IsaacDisnaut/RobotHead/robotface.png

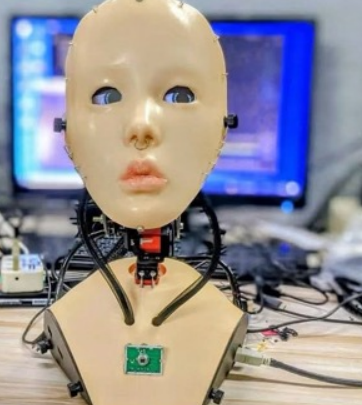
robotface.png
