IsaacDisnaut/RobotHead/README.md

# RobotHead — หุ่นยนต์หัว "น้องมะลิ"

หุ่นยนต์หัวพนักงานต้อนรับร้านเบเกอรี่ คุยภาษาไทยด้วยเสียงได้ หันหน้าตามคนที่อยู่ตรงหน้าหรือคนที่กำลังพูด กลอกตาบนจอกลมสองจอ และขยับปากตามเสียงพูด

- **ตา**: จอกลม GC9A01 1.28" × 2 แสดงลูกตาที่กะพริบ กลอกตา และม่านตาขยาย-หดได้
- **คอ**: เซอร์โว 2 ตัว (หันซ้าย-ขวา / ก้ม-เงย) ควบคุมด้วย ESP32-S3
- **ปาก**: เซอร์โว MG90S ควบคุมด้วย Arduino Nano ขยับตามเสียงพูด
- **สมอง**: โปรแกรม Python บนคอม ใช้กล้องหาใบหน้า ไมค์ฟังเสียง AI คิดคำตอบ แล้วพูดออกลำโพง
- **ความรู้**: ไฟล์ข้อความในโฟลเดอร์ [`information/`](information/) เช่น เมนูและราคา ข้อมูลร้าน

มีโปรแกรมให้เลือกใช้ 2 แบบ

| | โปรแกรมจำลอง (`simulator/`) — **แนะนำ** | `robot_brain.py` (รุ่นเดิม) |
|---|---|---|
| หน้าตา | เว็บในเบราว์เซอร์ มีโมเดลหุ่น 3D | หน้าต่างกล้อง OpenCV |
| AI | Groq (`api.txt`) | Gemini (`gemini_key.txt`) |
| อ่านโฟลเดอร์ `information/` | ✅ | ❌ |
| หันหาคนที่กำลังพูด | ✅ | ❌ (หันหาคนที่ใกล้สุดเท่านั้น) |
| เลือกลำโพงได้ | ✅ | ❌ (ใช้ลำโพงหลักของ Windows) |
| ใช้ได้โดยไม่ต่อหุ่นจริง | ✅ | ❌ |

---

## โครงสร้างโฟลเดอร์

```
├── simulator/                 โปรแกรมจำลอง + ตัวควบคุมหุ่นจริงผ่านเว็บ
│   ├── robot_sim_server.py    เซิร์ฟเวอร์ (AI, แปลงเสียง, กล้อง, Serial)
│   ├── เปิดโปรแกรมจำลองหุ่น.bat  ดับเบิลคลิกเพื่อเปิด
│   ├── web/                   หน้าเว็บ (Three.js)
│   └── models/                โมเดลตรวจจับใบหน้า YuNet (ใช้เมื่อ OpenCV ไม่มี Haar cascade)
├── firmware/
│   ├── robot_head/            เฟิร์มแวร์ ESP32-S3 (ตา + คอ)
│   └── jawduino/              เฟิร์มแวร์ Arduino Nano (ปาก)
├── information/               ข้อมูลที่หุ่นใช้ตอบคำถาม (.txt .md .csv .json .docx .pdf)
├── 3D_Print/                  ไฟล์ STL + G-code ลำตัวและโครงหัว (PETG)
├── robot_brain.py             สมองหุ่นรุ่นเดิม (ไม่ใช้เว็บ)
├── test_move.py               ทดสอบขยับหัวผ่าน Serial
├── haarcascade_frontalface_default.xml   โมเดลตรวจจับใบหน้า
├── โค้ดทั้ง2ฝั่ง/                โค้ดและผังวงจรรุ่นแรก (เก็บไว้อ้างอิง)
└── *.jpg                      ผังการต่อสาย ESP32-S3 / จอ GC9A01
```

---

## 1. ฮาร์ดแวร์และการต่อสาย

### อุปกรณ์

| อุปกรณ์ | จำนวน | หน้าที่ |
|---|---|---|
| ESP32-S3 (Flash 16MB, PSRAM OPI) | 1 | คุมจอตาและเซอร์โวคอ |
| จอกลม GC9A01 1.28" | 2 | ดวงตา |
| เซอร์โว (คอ) | 2 | Pan หันซ้าย-ขวา / Tilt ก้ม-เงย |
| Arduino Nano | 1 | คุมปาก |
| เซอร์โว MG90S | 1 | ขากรรไกร |
| แหล่งจ่ายไฟ 5V 2–3A | 1 | เลี้ยงเซอร์โวทุกตัว |
| เว็บแคม + ไมโครโฟน | 1 | ตาและหูของสมองบนคอม |
| ลำโพง (USB หรือสาย jack 3.5 มม.) | 1 | เสียงพูด ต่อกับคอม |
| โมดูล KA2284 | 1 | *ไม่บังคับ* — ตัวสำรองให้ปากขยับตามเสียงโดยไม่ต้องใช้คอม |

### ESP32-S3

| ต่อจาก | ไปที่ ESP32-S3 |
|---|---|
| จอ GC9A01 ทั้ง 2 จอ — DIN / SDA | GPIO 11 |
| จอ GC9A01 ทั้ง 2 จอ — SCL / SCLK | GPIO 12 |
| จอ GC9A01 ทั้ง 2 จอ — DC | GPIO 8 |
| จอซ้าย — CS | GPIO 10 |
| จอขวา — CS | GPIO 14 |
| เซอร์โว Pan — สายสัญญาณ (ส้ม/เหลือง) | GPIO 17 |
| เซอร์โว Tilt — สายสัญญาณ (ส้ม/เหลือง) | GPIO 18 |

> ⚠️ **ห้ามเลี้ยงเซอร์โวจากขา 5V ของบอร์ด** เซอร์โวดึงกระแสสูง ทำให้บอร์ดรีเซ็ตเอง ให้ใช้แหล่งจ่าย 5V ภายนอก แล้วต่อ GND ของแหล่งจ่ายเข้ากับ GND ของบอร์ด (Common Ground)

ดูรูปผังเพิ่มได้ที่ไฟล์ `การต่อ esp32 s3.jpg`, `การต่อ server esp32 s3.jpg` และ `การต่อจอแสดงผล GC9A01 (...).jpg`

### Arduino Nano (ปาก)

| ต่อจาก | ไปที่ |
|---|---|
| เซอร์โว MG90S — สายสัญญาณ (ส้ม) | Nano D9 |
| เซอร์โว MG90S — ไฟ (แดง) / กราวด์ (น้ำตาล) | แหล่งจ่าย 5V ภายนอก (GND ต่อร่วมกับ GND ของ Nano) |
| Nano USB | คอม (เส้นแยกจาก ESP32) |
| *(ไม่บังคับ)* KA2284 ขาลบ LED D2 / D3 / D4 | Nano A0 / A1 / A2 |

ถ้าไม่ได้ต่อ KA2284 ก็ไม่เป็นไร เฟิร์มแวร์ดึงขาไว้ด้วย `INPUT_PULLUP` อยู่แล้ว

---

## 2. ติดตั้งโปรแกรมบนคอม (Windows)

1. ติดตั้ง **Python 3.10** จาก [python.org](https://www.python.org/downloads/) ตอนติดตั้งให้ติ๊ก **Add Python to PATH**
2. เปิด Command Prompt ในโฟลเดอร์โปรเจกต์ แล้วติดตั้ง library

   ```bat
   pip install -r requirements.txt
   ```

   ถ้าติดตั้ง `PyAudio` ไม่ผ่าน ข้ามไปได้ถ้าใช้แค่โปรแกรมจำลอง (มันใช้แค่กับ `robot_brain.py`)

3. ใส่ API key (ไฟล์เหล่านี้อยู่ใน `.gitignore` จะไม่ขึ้น git)

   | ไฟล์ | ใช้กับ | ขอ key ที่ |
   |---|---|---|
   | `api.txt` | โปรแกรมจำลอง (Groq: คุย + แปลงเสียงเป็นข้อความ) | [console.groq.com/keys](https://console.groq.com/keys) |
   | `gemini_key.txt` | `robot_brain.py` (Gemini) | [aistudio.google.com/apikey](https://aistudio.google.com/apikey) |

   ใส่ key บรรทัดเดียวในไฟล์ เช่น `gsk_xxxxxxxx` หรือ `GROQ_API_KEY=gsk_xxxxxxxx` ก็ได้ ถ้าไม่มีไฟล์ จะอ่านจากตัวแปรสภาพแวดล้อม `GROQ_API_KEY` / `GEMINI_API_KEY` แทน

---

## 3. ลงเฟิร์มแวร์

ใช้ **Arduino IDE 2** (หรือ `arduino-cli`)

### ESP32-S3 — [`firmware/robot_head/robot_head.ino`](firmware/robot_head/robot_head.ino)

1. Boards Manager → ติดตั้ง **esp32 by Espressif Systems**
2. Library Manager → ติดตั้ง **GFX Library for Arduino** (moononournation) และ **ESP32Servo** (Kevin Harrington)
3. เลือกบอร์ด **ESP32S3 Dev Module** แล้วตั้งค่า
   - USB CDC On Boot: **Enabled**
   - Flash Size: **16MB**
   - PSRAM: **OPI PSRAM**
4. เปิด `robot_head.ino` (ไฟล์ภาพลูกตาอยู่ที่ `data/defaultEye.h` ต้องอยู่ข้างกัน) แล้วอัปโหลด

ด้วย arduino-cli: ค่าบอร์ดอยู่ใน [`sketch.yaml`](firmware/robot_head/sketch.yaml) แล้ว

```bat
cd firmware\robot_head
arduino-cli compile --upload -p COM12
```

### Arduino Nano — [`firmware/jawduino/jawduino.ino`](firmware/jawduino/jawduino.ino)

1. เลือกบอร์ด **Arduino Nano** (ถ้าอัปโหลดไม่ผ่าน ลอง Processor: **ATmega328P (Old Bootloader)**)
2. อัปโหลด
3. ปรับมุมปากให้เข้ากับกลไกได้ที่ `JAW_CLOSED` (หุบ) และ `JAW_OPEN` (อ้าสุด ไม่ควรเกิน 70)

---

## 4. ใช้งานโปรแกรมจำลอง (แนะนำ)

1. ดับเบิลคลิก `simulator/เปิดโปรแกรมจำลองหุ่น.bat`
   (หรือ `python simulator/robot_sim_server.py`)
2. เบราว์เซอร์จะเปิด <http://127.0.0.1:8765> เอง ให้ใช้ **Chrome หรือ Edge** → กด **คลิกเพื่อเริ่มจำลอง**
3. ปิดโปรแกรม: กด `Ctrl+C` ที่หน้าต่างดำ

### แท็บต่างๆ

| แท็บ | ทำอะไรได้ |
|---|---|
| 💬 คุยกับ AI | พิมพ์คุย, ปุ่มไมค์ (หยุดเองเมื่อเงียบ), โหมดฟังต่อเนื่อง |
| 🎮 ควบคุม | ปุ่มท่าทาง NOD/TILT/THINK/I, สไลเดอร์ Pan/Tilt/ตา, พิมพ์คำสั่ง Serial เอง, ทดสอบปาก |
| 📷 กล้อง | เปิดกล้องคอมเอง ตรวจหน้า และแสดงว่าหุ่นกำลังมองใคร (🎯 ใกล้สุด / 🗣️ กำลังพูด) |
| ⚙️ ตั้งค่า | กลับทิศเซอร์โว, ระยะที่เริ่มทักทาย, ความไวไมค์, ความเร็วเสียงพูด, **เลือกลำโพง**, ข้อมูลอ้างอิง, ต่อหุ่นจริง, สถานะ AI |

### ต่อหุ่นจริง

1. ปิด `robot_brain.py` และ Serial Monitor ของ Arduino IDE ก่อน (ใช้ COM พอร์ตเดียวกัน)
2. เสียบสาย USB ของ ESP32-S3 และ Nano — **เชื่อมต่อให้อัตโนมัติ** ไม่ต้องเลือก COM
   - เซิร์ฟเวอร์สแกนพอร์ต USB ทุก 3 วินาที ESP32-S3 ตอบ `STATUS ...` / Nano ตอบ `JAW OK`
   - ถอดสายแล้วเสียบใหม่ก็ต่อกลับเอง ป้ายด้านบนจะขึ้น "หุ่นจริง: COMx"
3. เลือกพอร์ตเองได้ที่แท็บ ⚙️ ตั้งค่า → **ต่อหุ่นจริง** ถ้ากด "ตัดการเชื่อมต่อ" ระบบจะหยุดค้นหาบอร์ดนั้นจนกว่าจะกดเชื่อมต่อใหม่
4. ไม่ต้องการให้ค้นหาเอง: `python simulator/robot_sim_server.py --no-serial`

### เลือกลำโพง

แท็บ ⚙️ ตั้งค่า → ช่องใต้ "ความเร็วเสียงพูด" → กด **ทดสอบ**
ถ้ายังไม่เคยเลือก ระบบจะเลือกลำโพงที่เสียบสาย jack (Realtek *Headphones*) ให้เอง
ชื่อลำโพงจะขึ้นหลังจากอนุญาตไมค์ครั้งแรก (กดไมค์หนึ่งครั้ง)

### หันหาคนที่กำลังพูด

ตอนไมค์ได้ยินเสียงพูด ระบบดูว่าใบหน้าไหนในกล้องขยับปากมากที่สุด แล้วหันไปหาคนนั้นแม้จะไม่ใช่คนที่ใกล้สุด พูดจบแล้วมองค้างไว้ 4 วินาที
ถ้าหันไม่ค่อยตรง ปรับ `SpeakerDetector.MIN_SCORE` ใน `robot_sim_server.py` (ดูตัวเลข 👄 บนจอกล้องประกอบ)

---

## 5. ใช้งาน `robot_brain.py` (รุ่นเดิม)

1. แก้ค่าด้านบนของไฟล์
   - `SERIAL_PORT` = COM ของ ESP32-S3
   - `JAW_SERIAL_PORT` = COM ของ Nano (หรือ `None` ถ้าไม่ต่อปาก)
2. รัน `py robot_brain.py`
3. ปิด: กดปุ่ม `q` ที่หน้าต่างกล้อง

---

## 6. ใส่ข้อมูลให้หุ่น (โฟลเดอร์ `information/`)

- ใส่ไฟล์ `.txt .md .csv .json .docx .pdf` ระบบโหลดใหม่เองเมื่อไฟล์เปลี่ยน
- ไฟล์ที่ชื่อขึ้นต้นด้วย `_` จะถูกข้าม (ใช้เก็บเทมเพลต/ร่าง)
- เขียนเป็นย่อหน้า เว้นบรรทัดว่างระหว่างหัวข้อ ขึ้นต้นด้วยหัวข้อที่ลูกค้าน่าจะถาม เช่น "เวลาเปิด-ปิด", "ราคาส่ง"
- หุ่นถูกสั่ง **ไม่ให้แต่งราคา/ตัวเลขที่ไม่มีในข้อมูล** ถ้าไม่มีจะบอกให้ถามพนักงาน
- เทมเพลตเมนู: [`information/_เมนูและราคา (เทมเพลต).txt`](information/_เมนูและราคา%20(เทมเพลต).txt)

> ราคาใน `เมนูและราคา.txt` ตอนนี้มาจากบทความรีวิวปี 2564 ควรอัปเดตเป็นราคาจริงของร้าน

---

## 7. คำสั่ง Serial (115200 baud)

### ESP32-S3

| คำสั่ง | ความหมาย |
|---|---|
| `T,pan,tilt,eyeX,eyeY` | หันหัว (pan 30–150, tilt 50–130, 90 = ตรง) และกลอกตา (0–1023, 512 = กลาง) ถ้าไม่ได้รับเกิน 2.5 วิ หุ่นกลับท่าพักเอง |
| `NOD` | ผงกหัว |
| `TILT` | เอียงคอฟัง |
| `THINK` | เหลือบตามองบน |
| `I` | กลับท่าพัก |
| `STATUS` | ตอบสถานะเซอร์โว/จอ |

### Arduino Nano (ปาก)

| คำสั่ง | ความหมาย |
|---|---|
| `J0` – `J100` | อ้าปาก 0 = หุบ, 100 = อ้าสุด (ไม่ได้รับเกิน 0.4 วิ จะกลับไปใช้ KA2284 / หุบปาก) |
| `DEBUG` | เปิด/ปิดการพิมพ์ค่าอนาล็อกจาก KA2284 |
| `PING` | ตอบ `JAW OK` |

ทดสอบหัวเร็วๆ: `py test_move.py COM12`

---

## 8. แก้ปัญหาที่พบบ่อย

| อาการ | วิธีแก้ |
|---|---|
| `AI ผิดพลาด: HTTP Error 429` | โควตา Groq ฟรีเต็ม ระบบจะสลับโมเดลสำรองให้เอง ถ้าเต็มทุกโมเดลให้รอสักพัก หรือลด `INFO_BUDGET` ใน `robot_sim_server.py` |
| เปิดกล้องไม่ได้ | ปิด `robot_brain.py` / โปรแกรมอื่นที่ใช้กล้อง แล้วกด **↻ เปิดกล้องใหม่** หรือเปลี่ยนหมายเลขกล้อง |
| เชื่อมต่อ COM ไม่ได้ | พอร์ตถูกใช้อยู่ (Arduino IDE Serial Monitor, `robot_brain.py`) ให้ปิดก่อน |
| เสียงไม่ออกลำโพงที่เลือก | ต้องใช้ Chrome/Edge และเสียงสำรองของเบราว์เซอร์ (ตอน gTTS ใช้ไม่ได้) จะออกลำโพงหลักของ Windows เสมอ |
| ปากจริงไม่ขยับ | เช็กว่าเชื่อมต่อพอร์ต Nano แล้ว พิมพ์ `PING` ใน Serial Monitor ต้องได้ `JAW OK` และเซอร์โวต้องมีไฟเลี้ยงภายนอก |
| บอร์ดรีเซ็ตเองตอนหัวขยับ | เซอร์โวกินไฟเกิน ใช้แหล่งจ่าย 5V 2–3A แยก และต่อ GND ร่วม |

---

## ชิ้นงานพิมพ์ 3 มิติ

ไฟล์อยู่ใน [`3D_Print/`](3D_Print/) — พิมพ์ด้วย PETG

| ชิ้น | STL | เวลาพิมพ์ |
|---|---|---|
| โครงหัว | `Head robot test01PLA.stl` | ~9 ชม. 14 นาที |
| ลำตัว | `body robot ok121069.stl` | ~10 ชม. 20 นาที |

ไฟล์ `.gcode` สไลซ์ไว้สำหรับเครื่องพิมพ์ที่ใช้ทำต้นแบบ ถ้าใช้เครื่องอื่นให้สไลซ์ใหม่จาก STL
