IsaacDisnaut/RobotHead/การต่อ esp32 s3.jpg

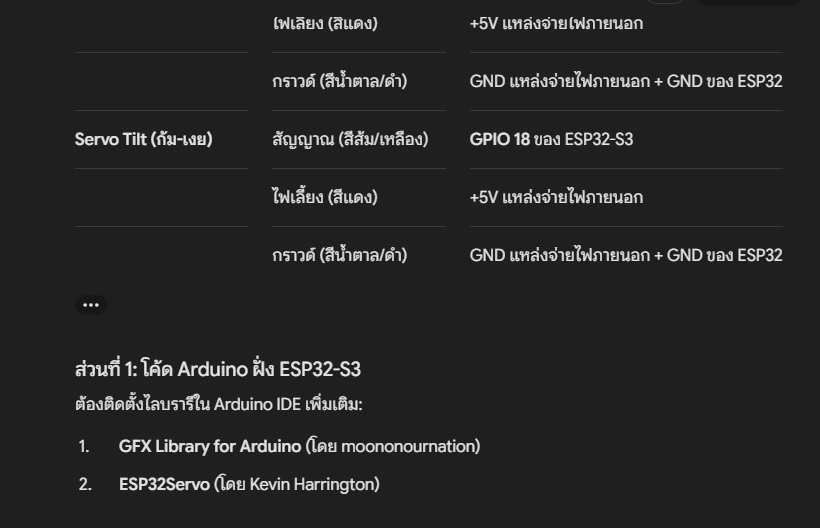
การต่อ esp32 s3.jpg
