IsaacDisnaut/RobotHead/การต่อ server esp32 s3.jpg

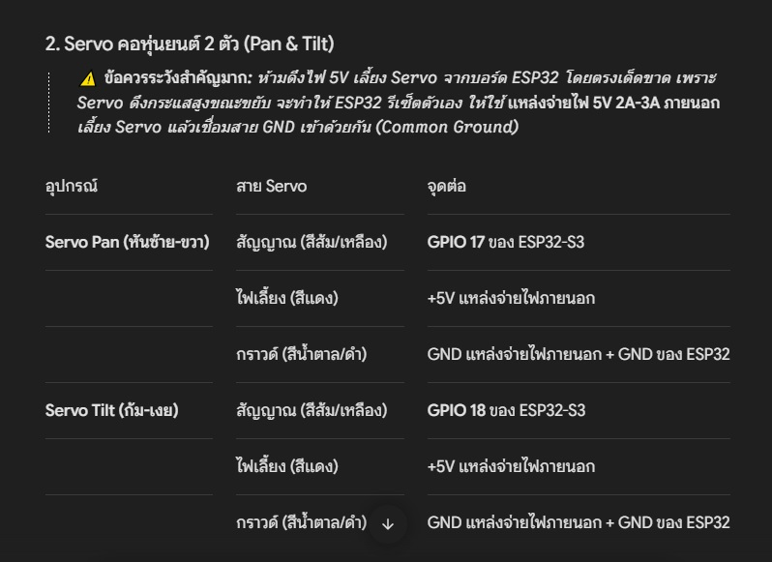
การต่อ server esp32 s3.jpg
