IsaacDisnaut/RobotHead/การต่อจอแสดงผล GC9A01 (2 จอ ใช้บัส SPI เดียวกัน) server esp32 s3.jpg

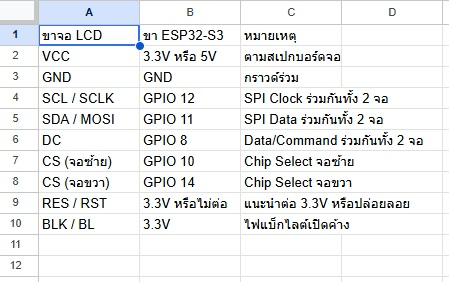
การต่อจอแสดงผล GC9A01 (2 จอ ใช้บัส SPI เดียวกัน) server esp32 s3.jpg
