IsaacDisnaut/RobotHead/3D_Print/body robot ok121069.stl

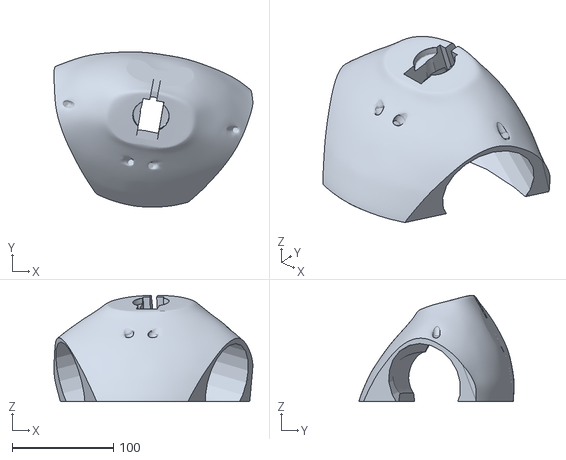
[picture p5: CAD file, 2026-11-03]
3D_Print/body robot ok121069.stl
196.1 x 152.9 x 104.8
