IsaacDisnaut/RobotHead/3D_Print/Head robot test01PLA.stl

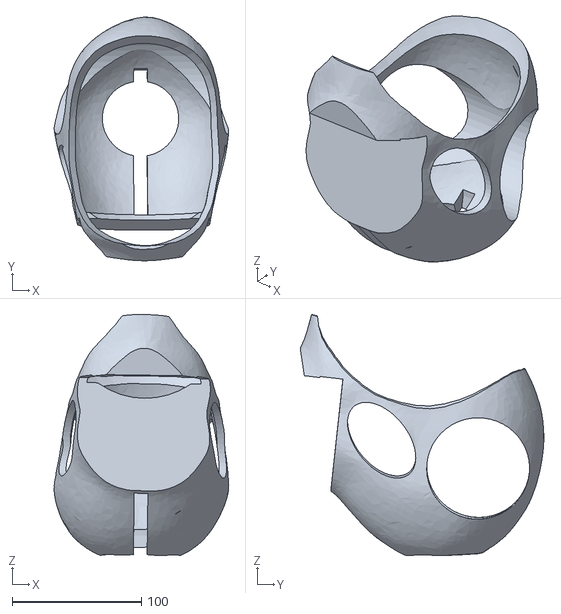
[picture p6: CAD file, 2026-11-03]
3D_Print/Head robot test01PLA.stl
135.0 x 188.4 x 186.4
