IsaacDisnaut/RobotHead/(commit log)

2026-11-03 Add Nong Mali robot head: firmware, simulator, brain and docs
    - ESP32-S3 firmware (eyes + neck) and Arduino Nano jaw firmware driven over USB
    - Web simulator: Groq chat with fallback models on 429, speaker-aware face tracking,
    output speaker selection, real-robot serial bridges for head and jaw
    - Bakery persona and information files (shop info, menu)
    - README with hardware wiring, setup, usage and troubleshooting
    - Move Gemini API key out of source into ignored gemini_key.txt
    [Head robot test01PLA.stl, body robot ok121069.stl]
2026-11-03 Auto-connect robot boards and retry Groq; fix launcher
    - Scan USB serial ports and auto-attach ESP32-S3 (STATUS) and Nano (JAW OK),
    reconnect after unplug; manual port selection still available
    - Retry Groq model discovery every 10s when offline at startup
    - Rewrite launcher .bat as ASCII + CRLF (Thai comment broke cmd); enforce CRLF for .bat
    - README: document auto-connect
    [robot_sim_server.py]
